nodecentral/Audi-Seat-Controller-Arduino-Project/README.md

# Audi Q8 Seat Control Reverse-Engineering Project

Repurposing an Audi `4N0959748D` switch assembly (Preh `13250-757/0200`) as a standalone control
interface for 12V seat motors in a different vehicle. This document tracks what's been measured
on the OEM hardware so far, the wiring scheme inferred from it, and what's still open before it
moves from the test bench into a vehicle.

> **Status:** the full chain — pushbutton → YYLOCK-2 power latch → buck converter → Nano → switch
> panel → Cytron → motor — is **confirmed working end-to-end on the bench** for two of the four
> axes (`fore_aft`, `recline`), including a dummy 12V motor. `front_tilt`/`rear_tilt` and the
> second Cytron board they need are **parked for now** (cost), not a technical blocker. Nothing has
> been installed in a vehicle yet — see
> [Vehicle integration checklist](#vehicle-integration-checklist) for what's still open before that.

## Voltage domains

This system has two electrically separate voltage domains that must never be tied together
directly:

| Domain | Voltage | Covers |
|---|---|---|
| **Motor power** | 12V (vehicle supply) | Cytron `B+`/`B-` terminals → seat motors only |
| **Logic** | 5V | Nano and its ADC reference |

The car is a 12V system, but the Nano and the switch panel's signal lines are **not** — the Nano's
ADC reads 0–1023 against a 5V reference. Feeding 12V into a Nano analog/digital pin or into the
switch panel's signal lines directly will exceed the pin's rating and damage it. The 5V rail is
**derived from the 12V supply through a buck converter** (module marked `C1205003` — see [Logic
supply](#vehicle-integration-checklist) below) — it isn't a separate source you wire in
independently. The switch panel's own pull-up doesn't come from this rail at all: the Nano reads
its analog pins with `INPUT_PULLUP` (its own internal pull-up resistor), confirmed working —
switch panel PIN 6 turned out not to be needed and isn't connected to anything.

## Hardware inventory

| Component | Part / model | Role |
|---|---|---|
| Seat switch panel | Audi `4N0959748D`, PCB marked Preh `13250-757/0200` / `NCE02` — also cross-referenced by resellers to Audi S3 (8Y) | OEM Audi switch cluster — passive input device, 12-position connector |
| Mating connector | TE Connectivity `1534096-1` / `1-1534096-1`, 12-cavity — [sourced from AliExpress](https://www.aliexpress.com/item/1005004665778565.html), pre-wired pigtail | Plugs into the switch panel; wires already terminated, ready to connect to the Nano — see caveat below |
| Motor driver | Cytron MDD10A | Dual-channel 10A H-bridge DC motor driver |
| Motor driver control cable | KF2510 2.54mm 5-pin pre-crimped cable, 20cm, 26AWG — sourced from eBay (listing: "KF2510 2.54mm Connectors & Wire Cable 2 3 4 5 6 Pin 20cm 26AWG UK SELLER", seller Electronic-Workshop) | Connectorised end mates with the MDD10A's `DIR1/PWM1/DIR2/PWM2/GND` header; the other end is bare flying leads that land on the Nano (via the HW-152 terminal adapter). Bought as a 2-pack, covering both this board and the second one still to be sourced |
| Microcontroller | Arduino Nano (ATmega328) | Reads switch panel, drives motor controller |
| Breakout | HW-152 "Nano Terminal Adapter V1.0" | Screw-terminal breakout for the Nano's header pins |
| Logic supply regulator | 12V→5V buck converter, module marked `C1205003`, 15W, 5V/3A max output | Steps the constant 12V feed down to 5V for the Nano and switch panel; see [Logic supply](#vehicle-integration-checklist) for the recommended wiring — bypass the pre-attached micro-USB cable |
| Power latch module | Garosa YYLOCK-2 self-locking delay-relay module, `SLA-12VDC-SL-C` relay, 30A/250VAC or 30A/30VDC at the module level, delay 0s–100min — sourced, bench-tested | Pushbutton-powered, self-latching wake/auto-off controller; its relay contacts also carry the actual switched load (Cytron `B+` + buck converter) — see [Power latch](#power-latch) |
| Power latch pushbutton | DMiotech 22mm momentary SPDT illuminated pushbutton (`C`/`NO`/`NC`), IP66 — sourced | User-facing wake trigger, dash or seat-mounted; only `C`+`NO` used, `NC` left disconnected; draws zero current when not pressed |

### Switch panel

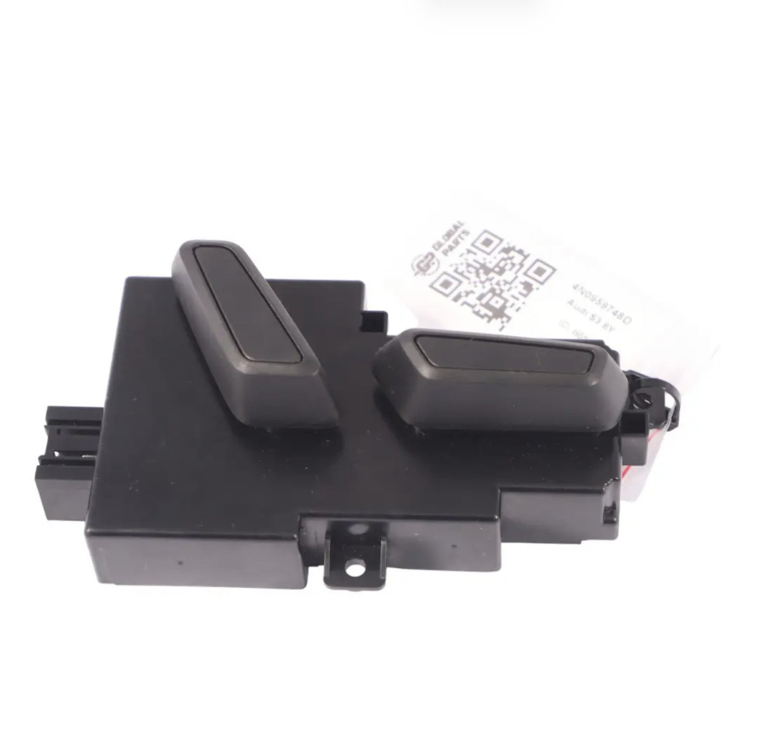
[picture p1: images/switch-unit-assembled.jpg]
Assembled switch unit with both rocker paddles


*Assembled unit as removed from the seat, part label `4N0959748D` / "Audi S3 8Y" visible. Two large
rocker paddles are what the user actually presses — not the eight individual tactile switches seen
on the bare PCB below. Each paddle rocks on 4 corners, each corner pressing a different underlying
switch: 2 paddles × 4 corners = the 8 switches already documented, and lines up exactly with 4
axes × 2 directions each. This is a standard mechanical pattern for this style of OEM seat switch.*

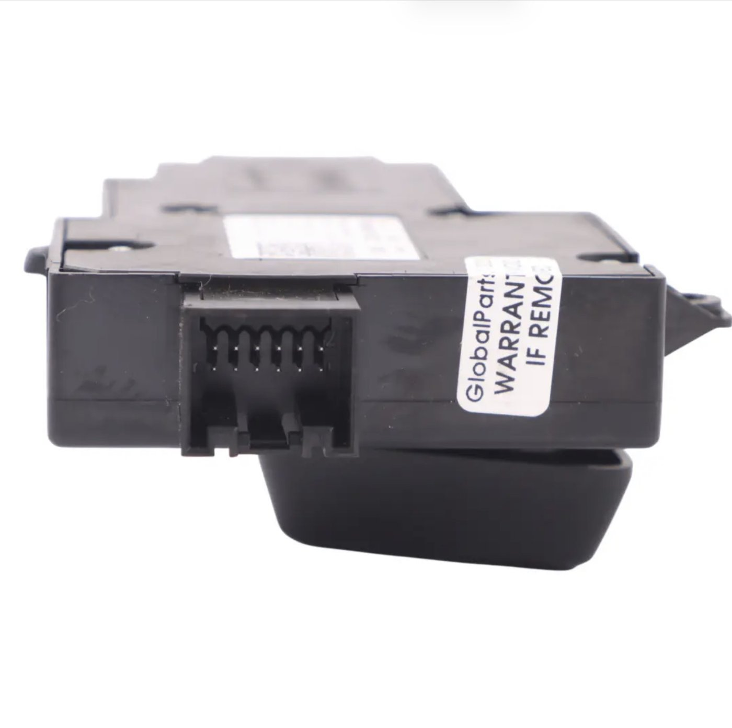
[picture p2: images/switch-unit-connector.jpg]
Male connector header molded into the switch housing


*The mating connector is molded directly into the housing — this is the physical point the TE
pigtail (below) plugs into.*

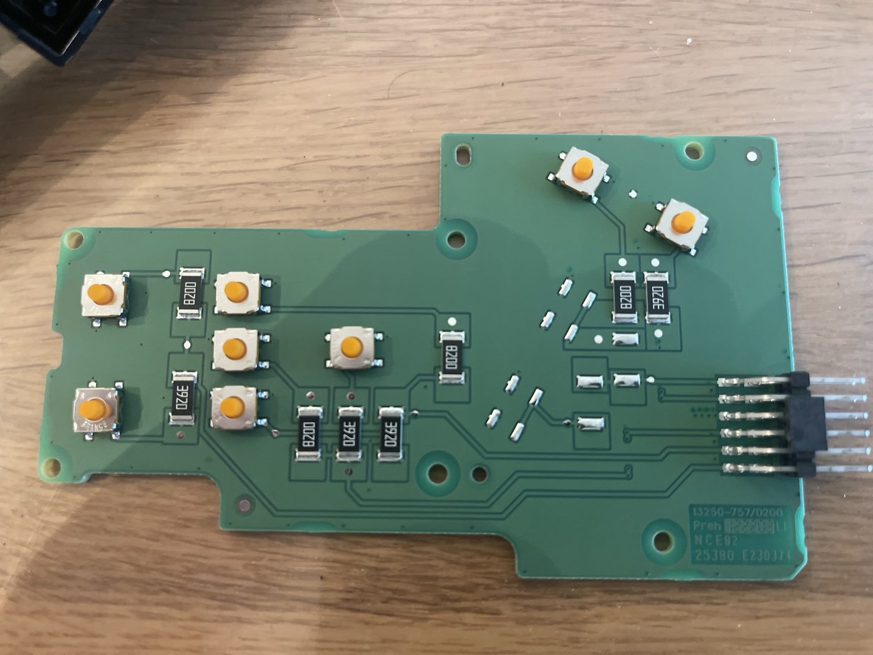
[picture p3: images/switch-panel-full.jpg]
Preh switch panel, full board


*Full switch panel (back side). Eight tactile switches are visible, wired through two repeated SMD
resistor values (silkscreened `8200` and `3920` — read as 820 Ω and 392 Ω using the standard
3-digit + multiplier code, unverified against a multimeter). Eight switches across four movement
axes lines up with two buttons (one per direction) per axis, each routed through a different
resistor — see [Inferred signal encoding](#inferred-signal-encoding) below.*

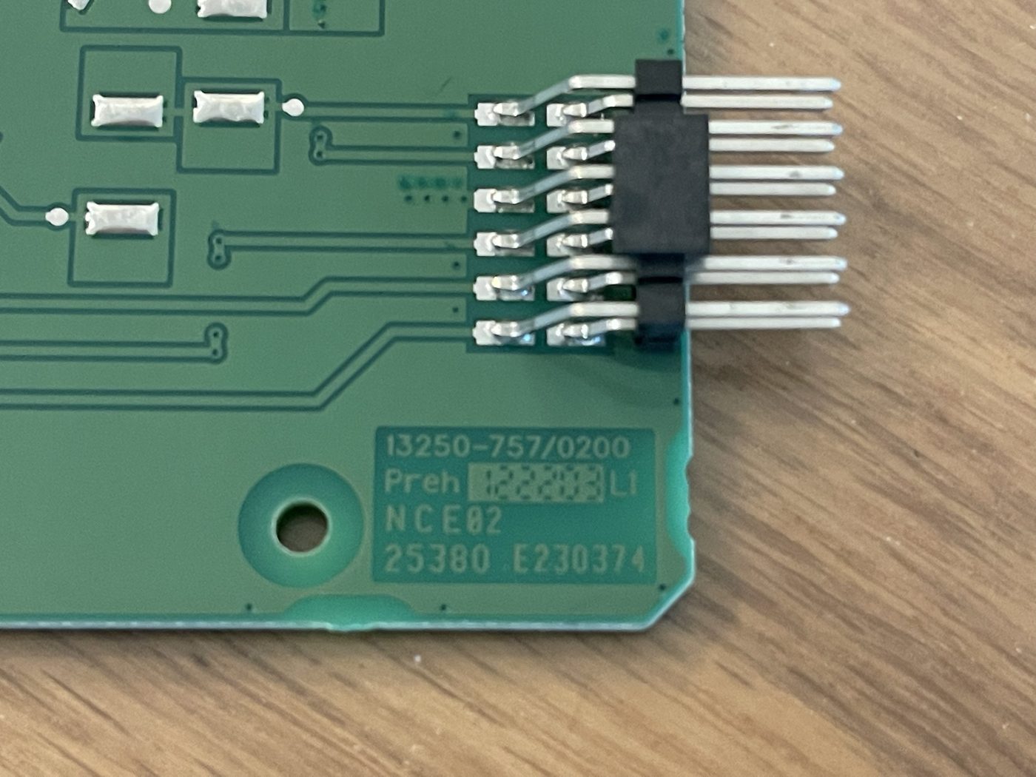
[picture p4: images/switch-connector-closeup.jpg]
Preh switch panel connector close-up


*Close-up of the panel's output connector, part marking `13250-757/0200 Preh NCE02 25380.E230374`.
The panel's case takes a 12-position mating connector (TE Connectivity `1534096-1` /
`1-1534096-1`) — only 6 of those 12 cavities have been identified as functional so far (see
[Confirmed control mapping](#confirmed-control-mapping)); the other 6 are unaccounted for, not
confirmed empty.*

> **Sourcing note:** that TE part number is what online listings sell as a match, cross-referenced
> against VW `8E0972112A` and described there as a "radar" harness connector — i.e. it's being sold
> as a generic shell reused across several VAG harnesses, not something listed specifically for this
> seat switch. A pre-wired pigtail version has been bought and physically mates with the panel,
> which confirms cavity count/pitch/keying are correct — what's still unconfirmed is which of the
> pigtail's 12 wires correspond to which of the panel's cavities (see below).

**Open item:** the pigtail presumably brings out all 12 wires, most likely colour-coded or otherwise
distinguishable per cavity — but that mapping (wire colour/position → cavity number → the PIN 1–6
functions already identified) hasn't been recorded here yet. Trace each wire from the connector back
to its cavity before wiring anything to the Nano, and don't rely on wire colour alone matching a
generic pinout found online, since this connector is sold as a shared shell across multiple VAG
applications.

### Motor driver

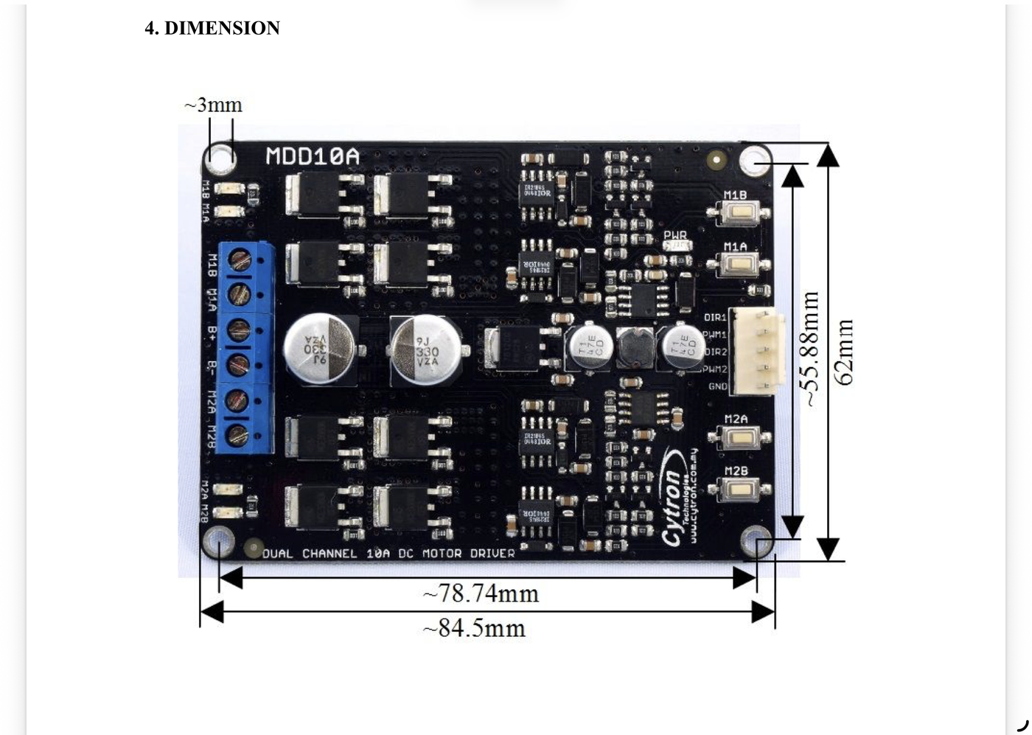
[picture p5: images/cytron-mdd10a-dimensions.png]
Cytron MDD10A dimensions and pinout


*Cytron MDD10A dual-channel 10A DC motor driver. Terminal block: `M1B / M1A / B+ / B- / M2A / M2B`.
Control header: `DIR1 / PWM1 / DIR2 / PWM2 / GND` — a standard 2.54mm 5-position connector, matched
by the KF2510 pigtail in the [hardware inventory](#hardware-inventory) above. This board only
drives two motors — see [Next Steps](#next-steps) for the implication on a 4-axis seat.*

**Resolved:** the KF2510 cable's 5 bare leads have been traced and landed on the Nano via the
HW-152 terminal adapter, matching the assignment in
[`seat_control_main.ino`](firmware/seat_control_main/seat_control_main.ino) — fore_aft: `D4`=DIR1
(black), `D5`=PWM1 (red); recline: `D7`=DIR2 (white), `D6`=PWM2 (yellow); GND=orange. Confirmed
from both ends, not assumed from a fixed wire-colour order — this specific cable turned out to be
plugged in reversed relative to the Cytron's own `DIR1/PWM1/DIR2/PWM2/GND` silkscreen order, which
is why cross-checking both ends mattered.

### Controller

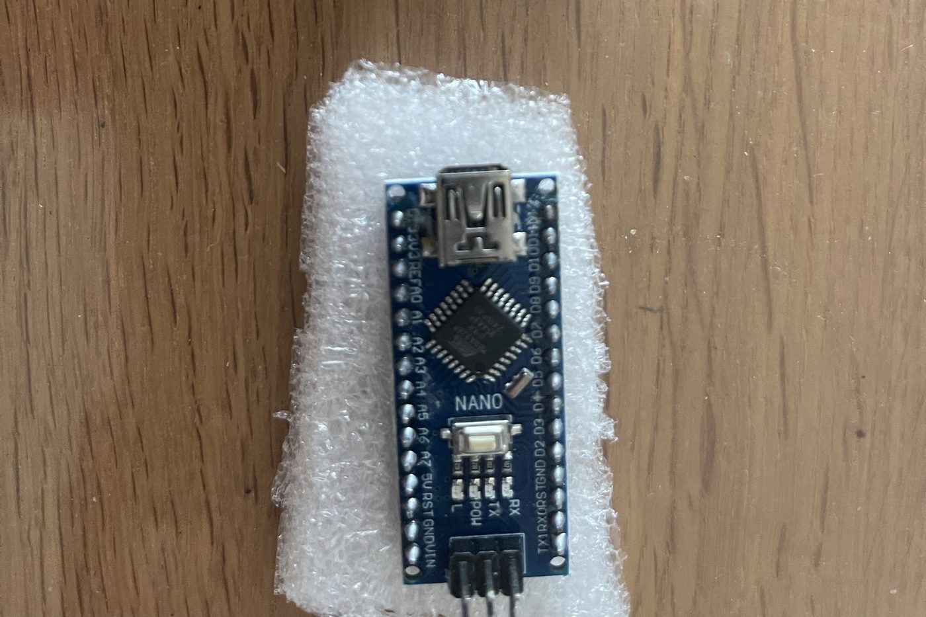
[picture p6: images/arduino-nano.jpg]
Arduino Nano

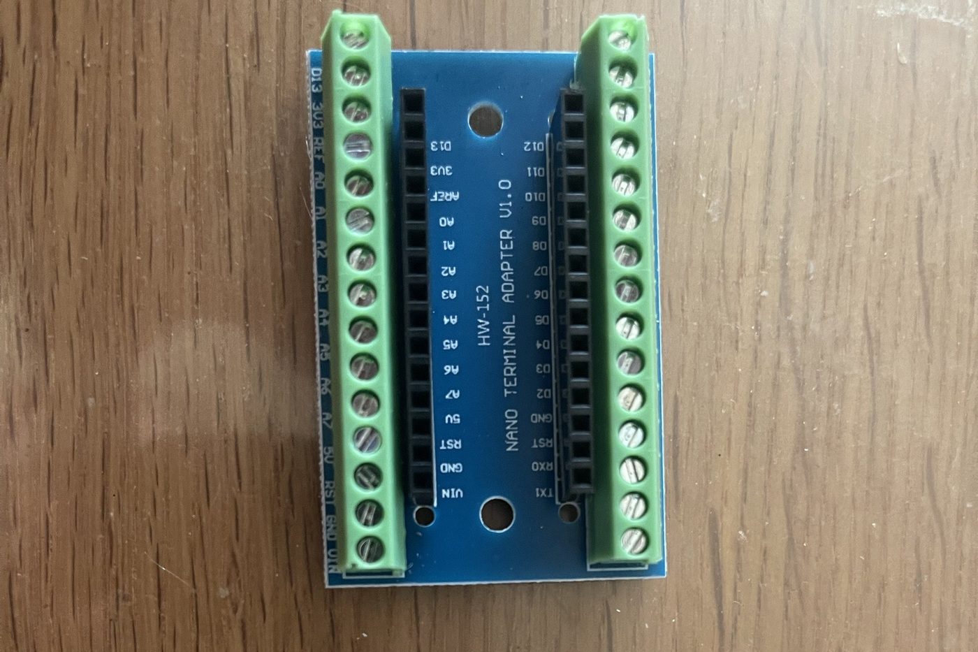
[picture p7: images/nano-terminal-adapter.jpg]
HW-152 Nano terminal adapter


*Arduino Nano and the HW-152 screw-terminal adapter used to break out its header pins for
solderless wiring to the switch panel and motor driver.*

## Key Findings

The switch PCB functions as a passive input device rather than a motor controller. Directional
information is encoded through resistance networks, not separate connector pins. The Arduino
successfully decoded PIN 1 signals (10-bit ADC, 0–1023):

| State | ADC reading |
|---|---|
| Neutral (no button pressed) | ~1023 |
| Downward adjustment | ~27–28 |
| Upward adjustment | ~40–41 |

The large gap between neutral (~1023, i.e. pulled high) and either pressed state (~27–41, pulled
sharply low) indicates a pull-up on the line with a low-value resistor switched in to ground on
each button press — different resistors per direction, which is exactly the two repeated SMD
values (820 Ω / 392 Ω) visible on the panel. That pull-up is the Nano's own internal one
(`INPUT_PULLUP`), confirmed working — not an external 5V feed (see [Voltage
domains](#voltage-domains)).

PIN 3 (fore_aft) and PIN 5 (recline) have since been independently confirmed on real hardware,
with very similar but not identical values — backward ~25–30, forward ~38–43. The small difference
from PIN 1's numbers above is expected: different axes' resistors and the switch to
`INPUT_PULLUP` both shift the exact thresholds slightly, which is exactly why each axis needs
measuring rather than assumed identical.

## Confirmed control mapping

| Pin | Function | Status |
|---|---|---|
| PIN 1 | Front seat-base tilt | Identified (ADC values above); axis not yet wired to a driver |
| PIN 2 | Rear seat-base tilt | Identified, ADC values not yet measured; axis not yet wired to a driver |
| PIN 3 | Entire seat forward/backward movement (`fore_aft`) | **Confirmed working** — Nano `A3` |
| PIN 4 | Common reference (ground) | Confirmed |
| PIN 5 | Backrest recline adjustment (`recline`) | **Confirmed working** — Nano `A5` |
| PIN 6 | Unused | **Confirmed not connected to anything** — not needed; the Nano's internal pull-up (`INPUT_PULLUP`) does this job instead |

The panel's mating connector has 12 cavities (see [hardware inventory](#hardware-inventory)); PINs
1–6 above are the ones identified so far. The remaining 6 cavities haven't been probed — they may
be unused on this panel variant, reserved for other functions (e.g. lumbar, memory buttons) present
on related Preh panels but not populated here, or something else entirely. Don't assume they're
empty until checked.

## Inferred signal encoding

Working theory for how each axis line behaves, based on the eight switches and two resistor values
on the panel plus the PIN 1 readings above. This is inferred from photos, not confirmed by
continuity testing — verify with a multimeter before relying on it:

```
         Nano internal pull-up (INPUT_PULLUP)
                         |
Nano ADC pin  <----------+----------  e.g. PIN 3 (fore_aft)
                         |
              +----------+----------+
              |                     |
         [~820R]                [~392R]
        "down" resistor       "up" resistor
              |                     |
          SW down                SW up
              |                     |
              +----------+----------+
                         |
                 PIN 4 (GND, common return)
```

Confirmed: the pull-up is internal to the Nano, not an external 5V feed — PIN 6 isn't connected to
anything (see [Confirmed control mapping](#confirmed-control-mapping)).

Each of the four movement pins (1, 2, 3, 5) is expected to follow this same pattern: idle high
(~1023), pulled to a low-but-distinct ADC value depending on which of the two direction buttons for
that axis is pressed. That matches the panel having 8 switches for 4 axes (2 directions each), and
the two SMD resistor values repeating across the board — and now that the assembled unit's been
seen (see [Switch panel](#switch-panel)), it also matches the physical layout exactly: 2 external
rocker paddles, each a 4-corner rocker, giving 2 × 4 = 8 underlying switches.

## Proposed system wiring

End-to-end wiring from battery to motors, based on the parts in the [hardware
inventory](#hardware-inventory). Only PIN 1's behavior is empirically confirmed; the rest of this
is a proposed build, not a verified one.

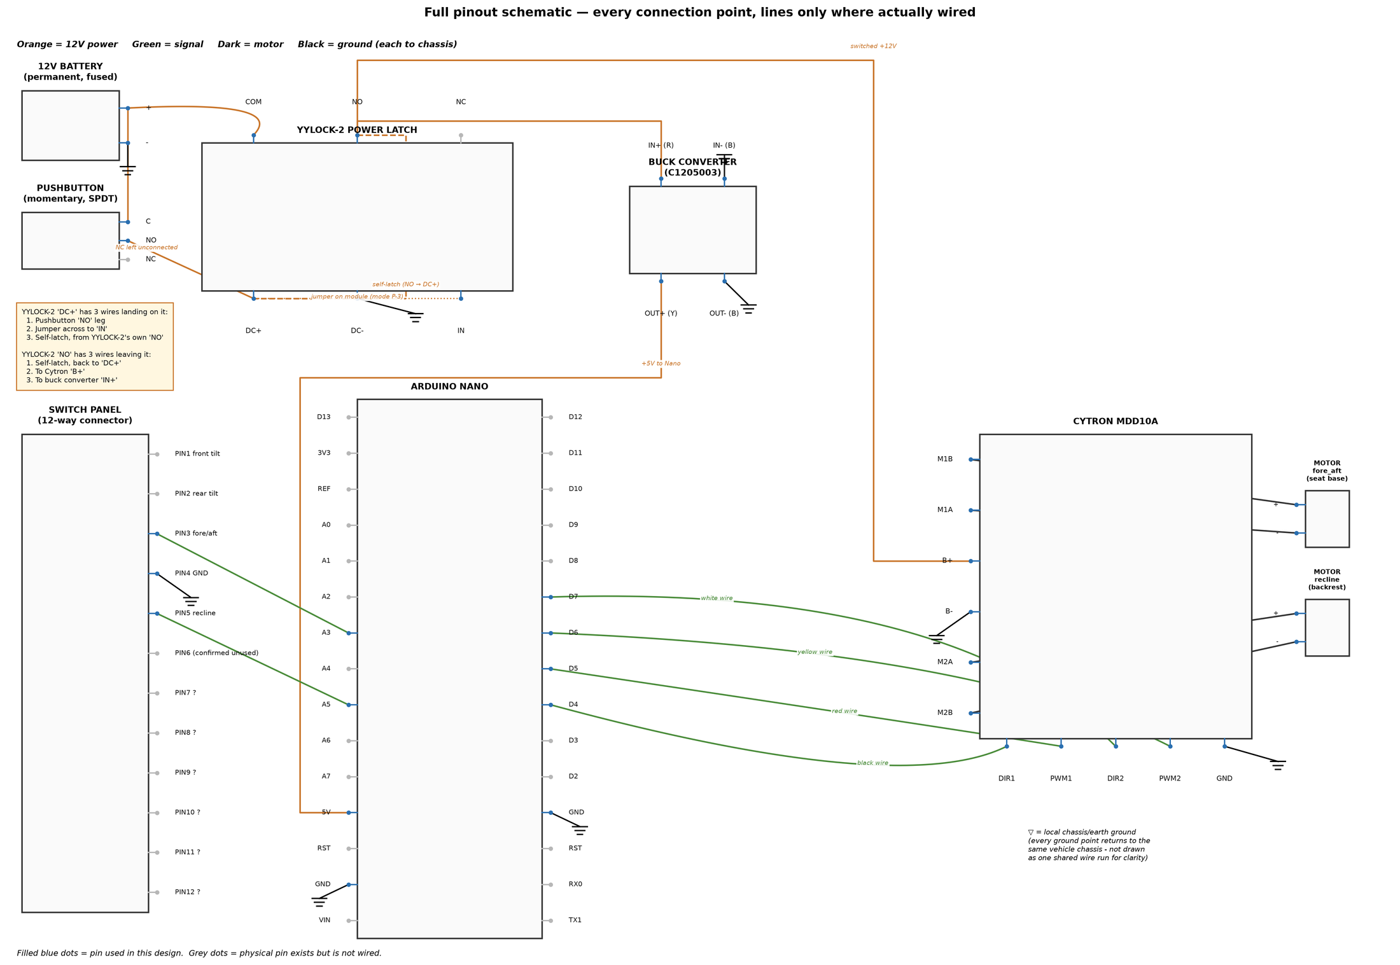
[picture p8: images/full-pinout-schematic.png]
Full pinout schematic showing every physical connection point on every component, with only the wired ones connected


*Every connection point on every component, drawn like a circuit board view — filled blue dots are
pins actually wired in this design; grey dots are real pins on the part that are simply unused
(e.g. the switch panel's 6 unidentified cavities, the pushbutton's and YYLOCK-2's `NC` contacts,
most of the Nano's pins). Orange = 12V power, green = signal, dark = motor output. Each `▽` is a
local chassis/earth ground symbol — every ground point (battery, YYLOCK-2, buck converter, Nano
×2, Cytron ×2, switch panel PIN 4) returns to the same vehicle chassis; they're drawn as separate
local symbols rather than one wire run joining them all, since in the car they don't share a
physical wire back to a single point anyway. The pushbutton is drawn as the real SPDT part (`C`/
`NO`/`NC`) — only `C` and `NO` are used, `NC` stays disconnected. The Nano↔Cytron control cable's
real wire colours are labelled on those four signal lines (black→`DIR1`, red→`PWM1`, yellow→
`PWM2`, white→`DIR2`) — confirmed on both ends: traced from the Nano side, then cross-checked
against the Cytron-side pin order you read directly off the cable (which turned out to be plugged
in reversed relative to the Cytron's own `DIR1/PWM1/DIR2/PWM2/GND` silkscreen order — both
readings agree, so this mapping is solid.*

For a lower-detail overview, the same system split into just power and signal flow:

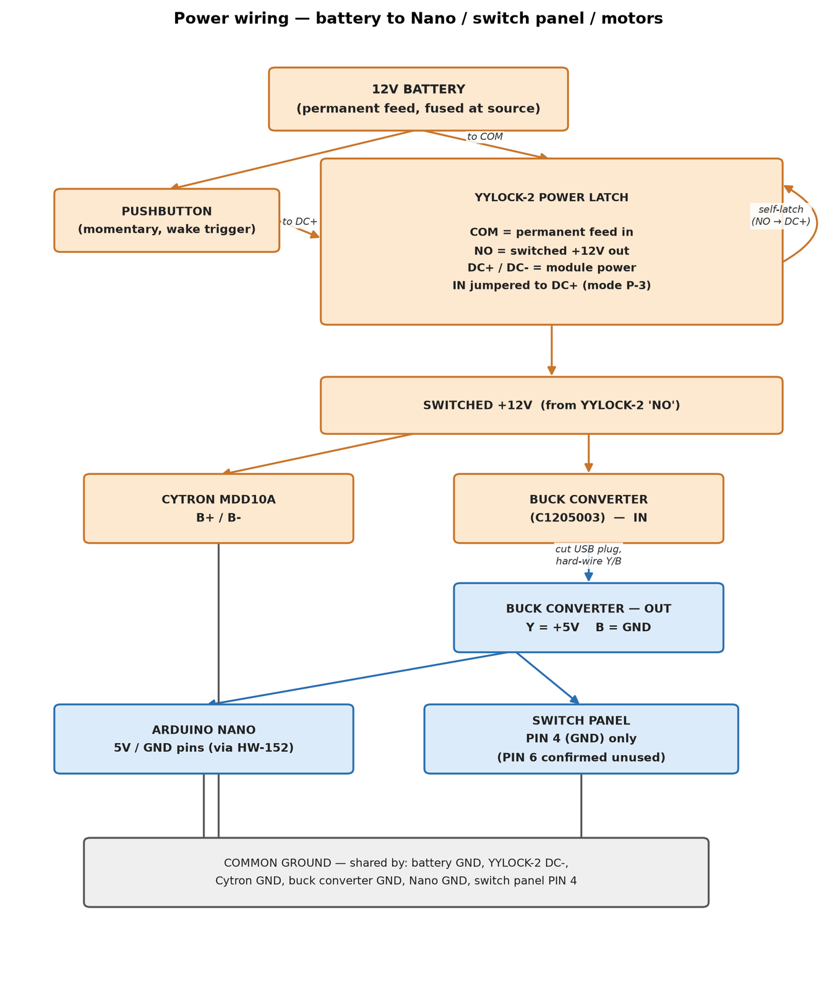
[picture p9: images/power-wiring.png]
Power wiring diagram: battery through the power latch to Nano, switch panel, and Cytron


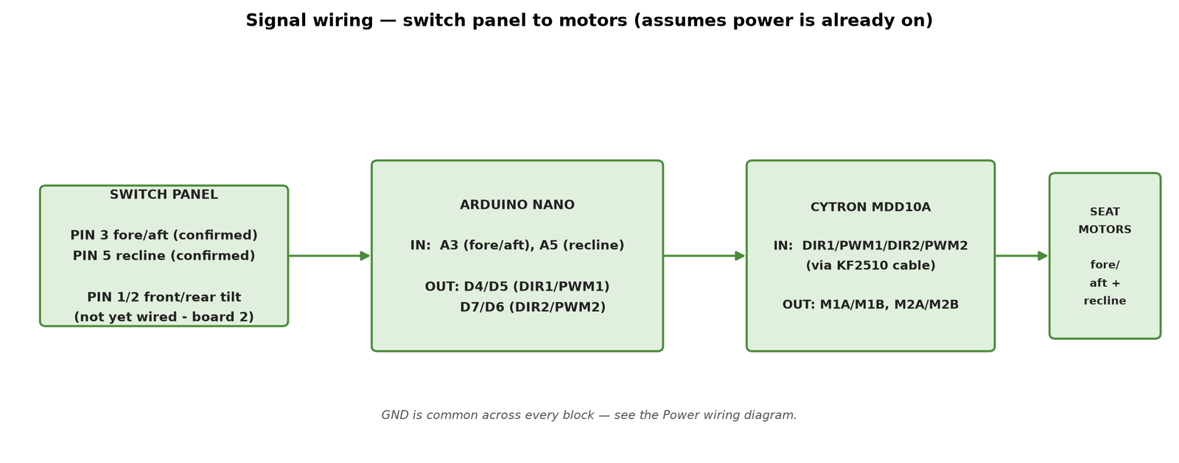
[picture p10: images/signal-wiring.png]
Signal wiring diagram: switch panel through Nano and Cytron to the motors


A pin-level Mermaid version of the same system, for reference:

```mermaid
flowchart LR
    subgraph SWITCH["Preh switch panel (13250-757/0200)"]
        P1["PIN 1 — front tilt<br/>(not yet wired to a driver)"]
        P2["PIN 2 — rear tilt<br/>(not yet wired to a driver)"]
        P3["PIN 3 — fore/aft"]
        P5["PIN 5 — recline"]
        P4["PIN 4 — GND"]
        P6["PIN 6 — confirmed unused"]
    end

    subgraph NANO["Arduino Nano (via HW-152 terminal adapter)"]
        A3n["A3"]
        A5n["A5"]
        GND1["GND"]
        FIVEV["5V"]
        CTRL1["D4/D5 — DIR1/PWM1 (fore_aft)"]
        CTRL2["D7/D6 — DIR2/PWM2 (recline)"]
    end

    subgraph DRV1["Cytron MDD10A #1 (drives 2 of 4 axes)"]
        M1["M1A/M1B"]
        M2["M2A/M2B"]
        BSUP["B+ / B-"]
    end

    P3 --> A3n
    P5 --> A5n
    P4 --> GND1
    REG -. proposed .-> FIVEV

    CTRL1 --> M1
    CTRL2 --> M2

    MOT1["Seat motor — fore_aft (seat base)"]
    MOT2["Seat motor — recline (backrest)"]
    M1 --> MOT1
    M2 --> MOT2

    BATT["12V vehicle supply, permanent, fused"] --> PBTN["Pushbutton<br/>(not yet sourced)"]
    BATT --> LATCH["YYLOCK-2 'COM'"]
    PBTN --> DCPLUS["YYLOCK-2 'DC+'<br/>(IN jumpered to DC+, mode P-3)"]
    LATCH -- closes onto NO when triggered --> NOOUT["YYLOCK-2 'NO'<br/>(switched +12V out)"]
    NOOUT -- self-latch --> DCPLUS
    NOOUT --> BSUP
    NOOUT --> REG["12V→5V buck converter<br/>(C1205003, hardwired — no USB cable)"]
    BSUP --> M1
    BSUP --> M2

    DRV2["Cytron MDD10A #2 (needed for remaining 2 axes:<br/>front tilt and rear tilt on D2/D3 and D8/D9,<br/>exact pairing TBD)<br/>— not yet built"]
    CTRL1 -.-> DRV2
```

Note only two of the four confirmed movement axes can be driven per MDD10A board — a second driver
board is needed to cover all four (see Next Steps). The 12V supply only ever reaches the `B+`/`B-`
motor terminals; everything else (switch panel, Nano, ADC lines) runs on the 5V rail produced by
the regulator, per [Voltage domains](#voltage-domains).

## Power latch

The controller needs to work with the ignition off (so seat position can be adjusted before
getting in), but the whole point is that it must **not** sit drawing current 24/7 off the permanent
12V feed — that's how you come back to a dead battery. Solution: a single self-locking delay-relay
module (Garosa YYLOCK-2 or equivalent: `SLA-12VDC-SL-C` relay, 30A/250VAC or 30A/30VDC rated at the
module level — not just the bare relay chip, terminals sized to match) whose own power input, not
just a signal pin, is gated by a pushbutton. At rest, nothing downstream has any power at all.

```
+12V permanent (fused) ----+------------------------------------+
                            |                                    |
                      [pushbutton]                          YYLOCK "COM"
                      (momentary)                        (permanent feed in)
                            |                                    |
                            +--------------+          closes onto "NO" when
                                           |            the relay is energized
                                     YYLOCK "DC+" <----------- YYLOCK "NO"
                                           |               (switched +12V out)
                                     YYLOCK "IN" (jumpered to DC+
                                     on the module itself — mode P-3)
                                           |
                                     YYLOCK "DC-" ---> common GND

switched +12V (from "NO") ---> Cytron B+ and buck converter IN (both fed from here)
```

- **Wake:** pressing the pushbutton applies 12V to the module's `DC+`/`DC-`. Because `IN` is
  permanently jumpered to `DC+`, the module sees itself as already triggered the instant it powers
  up — no separate trigger wiring needed.
- **Mode P-3** ("Timed Output Mode"), per the module's manual: *"if the input is continuously
  shorted, the relay activates for the set delay period and then deactivates until power is
  removed."* That's the whole behavior in one sentence — relay closes immediately, stays closed for
  a delay set via the `SET` button (aim for 10–15 minutes), then opens and stays open until power
  is fully cycled again.
- **Self-latch and load, same contact:** the relay's `NO`/`COM` pair is wired back to `DC+` in
  parallel with the pushbutton (so releasing the button changes nothing — the module now holds its
  own power on) **and** feeds the buck converter + Cytron `B+` downstream. One 30A-rated contact
  pair does both jobs — no separate main relay needed, unlike the two-stage design this replaces.
  Concretely, that means `DC+` has **3 wires** landing on it (pushbutton `NO`, the `IN` jumper,
  and this self-latch wire), and `NO` has **3 wires** leaving it (self-latch back to `DC+`, to
  Cytron `B+`, to the buck converter's `IN+`) — easy to undercount at a glance in the diagram, so
  spelled out here and called out directly on the schematic itself.
- **Auto-off:** when the set delay elapses, the relay opens, cutting its own power and the
  downstream load together — including the Nano. At rest, the pushbutton is open and the module has
  no power on it: draw is genuinely zero.
- **No firmware role:** `seat_control_main.ino` has no power-management code — the module handles
  wake and timeout entirely on its own hardware.

Other modes exist (`P-1` self-locking/toggle, `P-2` power-off delay, `P-4` delayed-on) but none fit
this use case — see the module's manual for the full function list if reconsidering.

**Bench-tested and confirmed** (module + pushbutton + multimeter, nothing else attached):
- Mode `P-3` with `IN` shorted to `DC+` behaves exactly as documented: relay clicks on immediately,
  stays on for the set delay, then clicks off on its own. Retriggering `IN` while already active
  does **not** extend the delay — matches the manual's "subsequent input signals during the delay
  period are ignored," and is what this design wants (fixed, generous duration, no need to keep it
  retriggered). One practical consequence: if a seat-adjustment session ever runs longer than the
  set duration, the system will power off mid-session and need the wake button pressed again.
- The module retains its configured mode and delay across a full power cycle, as advertised — this
  mattered more here than usual, since the module's own power is cut every time it sleeps by
  design.
- Timing dial: turning it **clockwise decreases** the delay, anti-clockwise increases it (per the
  board's own label). The mode switch also controls whether the dial's range is seconds or
  minutes — worth double-checking that switch position, since it's easy to read a "few seconds"
  result as broken when it's actually just set to minutes (or vice versa).

**Still open:**
- Confirm real-world current handling under a load similar to actual motor stall current before
  trusting the 30A rating for good — the module-level rating is more credible than a bare relay
  chip's printed number, but hasn't been independently verified here.

## Firmware

| Sketch | Purpose |
|---|---|
| [`firmware/diagnostic_read_switch_panel`](firmware/diagnostic_read_switch_panel/diagnostic_read_switch_panel.ino) | Prints raw ADC values for `fore_aft`/`recline` (confirmed working) plus the two unconfirmed `front_tilt`/`rear_tilt` pins (`A1`, `A2`) over serial. Use it once the second Cytron board exists to find out which of `A1`/`A2` is which axis. |
| [`firmware/seat_control_main`](firmware/seat_control_main/seat_control_main.ino) | Control loop: reads all four axes, drives the Cytron board(s), and stops a motor if it's held on past an 8-second safety cutoff. Has no role in power management — the [power latch](#power-latch) handles wake/auto-off entirely in hardware. `fore_aft`/`recline` thresholds are confirmed working; `front_tilt`/`rear_tilt` copy the same placeholder values until that board exists and gets measured. |

`fore_aft` and `recline` are confirmed running on real hardware, using the Nano's internal
`INPUT_PULLUP` rather than an external 5V feed. `front_tilt`/`rear_tilt` are still inert pending
the second Cytron board.

## Vehicle integration checklist

Not started. Before any of this touches a vehicle:

- **Wire gauge** — two sizes, not one: **16 AWG (~1.5mm²)** for anything on the direct
  battery-to-motor current path (power in → YYLOCK-2 `COM`, `NO` → Cytron `B+`, `B-` → ground, and
  the 4 motor output wires) — sourced from existing stock, confirmed stranded (not solid core) and
  genuinely full-gauge copper before use, given it's carrying the only real current in this build.
  **22 AWG (~0.33mm², Fermerry silicone/tinned-copper hookup wire, 6 colours)** for everything
  else — switch panel signals, Nano↔Cytron control signals, the buck converter's input and output,
  and the YYLOCK-2/pushbutton/LED wiring. Simple rule: thick wire only between the battery and a
  motor terminal, thin wire for everything else.
- **Power source** — decided: a permanent 12V feed, already fused from the car's main board into a
  fuse box. Add a dedicated small inline fuse there for this circuit specifically, sized to what it
  actually draws — the existing upstream fuse protects the main distribution wiring, not this
  circuit's own branch wire (see [Next Steps](#next-steps)). Seat adjustment needs to work with the
  ignition off, which rules out simply gating this off an ignition-switched circuit — instead the
  feed goes through the [power latch](#power-latch) relay, so the controller draws no standby
  current between uses despite being fed from a permanent source.
- **Logic supply** — sourced: a 12V→5V buck converter (module marked `C1205003`, 15W, rated 5V/3A
  output — comfortably more than the Nano will ever draw; the switch panel doesn't need any of this
  rail, since it's read via the Nano's own internal pull-up, not an external 5V feed). It
  comes with a pre-attached micro-USB cable meant for powering the Nano through its USB port — for
  a permanent vehicle install, **don't use that USB connection**. A USB plug isn't rated for
  continuous vibration and is one more failure point with no benefit here. Instead: cut off (or
  ignore) the micro-USB plug, and wire the module's `Y` (yellow, +5V out) and `B` (black, GND out)
  leads directly into the Nano's `5V` and `GND` pins via the HW-152 terminal adapter you already
  have. Fuse the module's `R` (red, 12V in) lead separately from the motor supply fuse — 1A is
  ample headroom for what this rail actually powers. **Never connect 12V straight to the Nano's
  `5V` pin** — only the module's regulated 5V *output* goes there; the module's 12V *input* side is
  a completely separate pair of wires. Confirm from the MDD10A datasheet whether it already has an
  onboard 5V logic output before assuming you need this converter for anything beyond the Nano.
- **Common ground** — switch panel PIN 4, Nano GND, both Cytron boards' GND, and the 12V supply
  return all need to share one reference; a floating or high-resistance ground will show up as
  garbage ADC readings on the switch panel lines before it shows up anywhere else.
- **Target motor ratings** — get the stall current and connector type for the seat motors in the
  destination vehicle. The MDD10A is rated 10A/channel continuous; confirm the motors' stall
  current stays under that with margin, and size wiring/fuses to the stall figure, not the running
  figure.
- ~~**Connector matching**~~ — done: pre-wired pigtail (TE `1534096-1` / `1-1534096-1`) bought and
  confirmed to mate with the panel. Still open: trace and record which of its 12 wires land on
  which cavity, per the note under [Switch panel](#switch-panel).
- **Enclosure** — sourced: **Hammond `1599HBK`**, IP54 black ABS, 220×110×44mm external. Houses
  all four boards (YYLOCK-2, buck converter, Nano, Cytron). Connectors sourced to match: two
  9-pin 5.08mm pluggable panel-mount terminal blocks (one for the pushbutton, one for the switch
  panel — both grouped on the seat-facing side, since both route there), a 4-pin for the motor
  outputs, a 2-pin for power in — 3 physical connection points total, panel-mount/pluggable so the
  box can be unplugged from the harness rather than desoldered.

  **Depth is the thing to verify before final mounting, not footprint.** 44mm external is roughly
  36–38mm clear internal once you allow for the walls and a mounting plate. The YYLOCK-2's relay is
  the tallest single component in this build (a 30A-rated relay body is commonly 20–25mm on its
  own) — stacked with the PCB and any standoff clearance, that's plausibly pushing 28–32mm. It
  likely fits, but closely enough that it's worth measuring the actual relay height and the box's
  real internal clearance before drilling or gluing anything down. A physical dry-fit settles this
  faster than any diagram can.

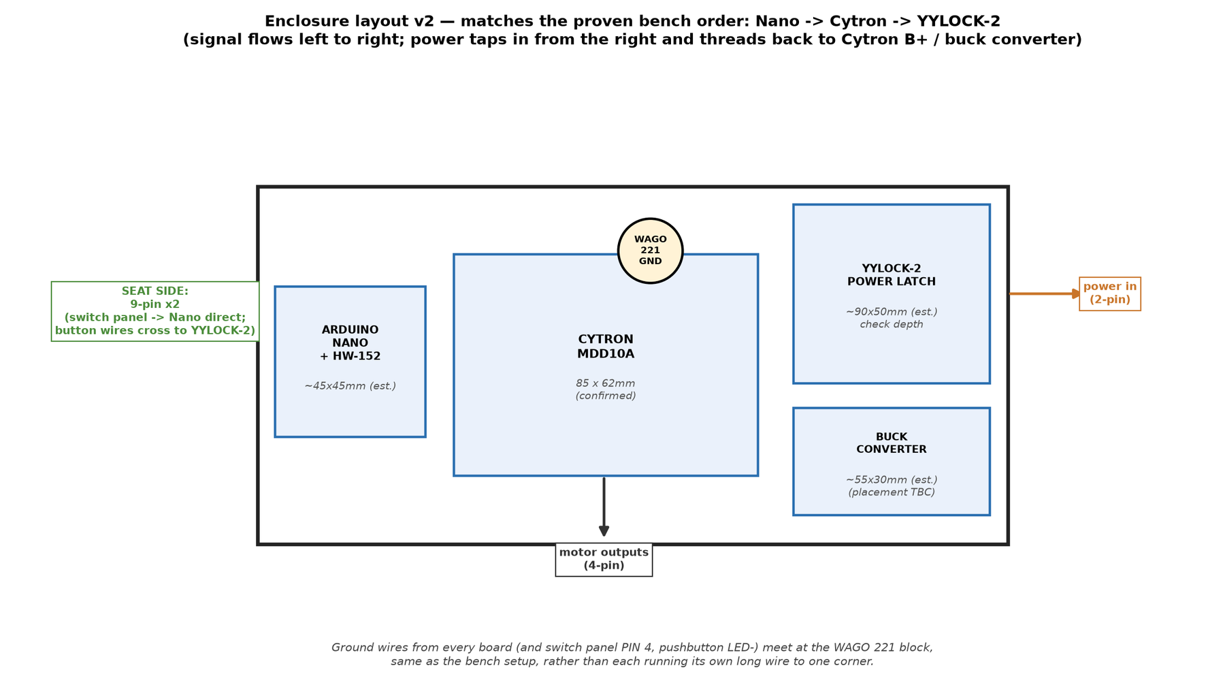
[picture p11: images/enclosure-layout.png]
Enclosure layout for the Hammond 1599HBK: top-down view showing Nano, Cytron, YYLOCK-2, buck converter, and WAGO ground block placement, matching the proven bench order
  

  *Layout follows the order already proven working on the bench: **Nano → Cytron → YYLOCK-2**,
  left to right. Signal flows one direction — switch panel into the Nano (left), Nano's control
  lines into the Cytron (middle), Cytron's outputs to the motors (bottom) — while power taps in
  from the right (near the YYLOCK-2) and threads back to Cytron `B+` and the buck converter. A WAGO
  `221` lever connector serves as the common ground junction, same as on the bench, rather than
  each board running its own long wire to one corner. Buck converter is grouped with the YYLOCK-2
  since that's where it takes its input from — flag if it should sit elsewhere. About a third of
  the footprint is spare, so this is one workable arrangement, not the only one.*

## Next Steps

**Parked for now:** `front_tilt`/`rear_tilt` and the second Cytron MDD10A board they need are
deliberately deferred — cost-driven decision, not a technical blocker. The items below (measuring
PINs 1/2, finding which of `A1`/`A2` is which axis, sourcing the second board, updating their
placeholder thresholds) all wait on that decision being revisited.

- Measure the YYLOCK-2 relay's actual height and the Hammond `1599HBK`'s real internal clearance
  before final mounting — see [Enclosure](#vehicle-integration-checklist), depth is tight.
- Confirm the two SMD resistor values (silkscreened `8200` / `3920`) by direct measurement rather
  than reading the printed code from photos.
- Probe the 6 unaccounted-for cavities on the 12-position connector — confirm whether they're
  genuinely unused or carry signals not yet identified.
- The pigtail wires actually needed (PINs 3, 4, 5) are landed and confirmed working end-to-end on
  the bench. The other 9 cavities' wires still aren't traced/recorded — not blocking, since nothing
  currently needs them, but worth doing before assuming the rest of the pigtail is understood.
- ~~Wire the buck converter's `Y`/`B` output leads directly to the Nano's `5V`/`GND` pins~~ — done,
  confirmed working on the bench (no micro-USB cable used).
- ~~Source and bench-test the power latch module~~ — done, see [Power latch](#power-latch):
  P-3 behavior and settings-retention across a power cycle both confirmed on real hardware.
- **Fine-tune later, once it's installed and has run reliably for a while:** an optional small
  electrolytic capacitor (100–470µF) across the YYLOCK-2's `DC+`/`DC-`, to make the power-on more
  tolerant of a soft/incomplete pushbutton press — smooths a brief or bouncy contact into a more
  sustained power pulse. Not needed now; the button just needs a firm, deliberate press, which is a
  reasonable property for a wake button anyway. Revisit only if it proves annoying in practice.
- **Roadmap, not release 1:** drop the buck converter and power the Nano directly from `VIN`
  instead (7–12V straight from the switched rail, using the Nano's own onboard regulator) — viable
  now that PIN 6 is confirmed unused, since the buck converter's only remaining job is powering the
  Nano itself, whose draw is small enough that the regulator's efficiency loss is negligible. Would
  take this from a 4-board build down to 3. Release 1 keeps the buck converter as-is — it's already
  wired, tested, and working, and it gives a bit of extra regulation headroom as a safeguard over
  relying on the Nano's own onboard regulator. Worth exploring properly on the second build (a
  second instance of this whole project is planned) rather than reworking the proven one.
- Decide on and mount the pushbutton location (dashboard vs. seat).
- Vehicle power source: a fused 12V feed already exists from the main board into a fuse box.
  **Add a dedicated small inline fuse there for this circuit specifically** — the upstream fuse
  protects the main distribution wiring, not this circuit's own (thinner) branch wire, so it needs
  its own fuse sized to what this circuit actually draws. Pick the rating once real-world stall
  current is measured (see [Power latch](#power-latch) — still open).
- Work through the rest of the [vehicle integration checklist](#vehicle-integration-checklist) —
  chassis grounding, connector matching, enclosure — before connecting any seat motor in the car.
  Do not wire B+/B- to the vehicle 12V supply until that's done.
