nodecentral/Audi-Seat-Controller-Arduino-Project/(commit log)

2026-09-13 Document reverse-engineering process for Audi seat control
    Added detailed notes on reverse-engineering the Audi Q8 seat control switch, including objectives, findings, pin mapping, and proposed Arduino architecture.
2026-09-13 Restructure README with photos and inferred wiring diagram
    Adds hardware photos (switch panel, Cytron MDD10A driver, Arduino Nano
    + terminal adapter), a PIN 6 hypothesis based on the resistor-ladder
    pattern visible on the switch board, and a proposed end-to-end wiring
    diagram from switch panel through to the motor driver.
2026-09-13 Add draft firmware and vehicle integration checklist
    Diagnostic sketch reads all four switch-panel axes for the still-missing
    PIN 2/3/5 calibration data. Main control sketch drafts the Nano-to-Cytron
    control loop with a safety cutoff, using placeholder thresholds copied
    from the confirmed PIN 1 measurement. README gains a Firmware section and
    a vehicle integration checklist covering power, grounding, motor ratings,
    connectors, and enclosure — none of which has been designed yet.
    [diagnostic_read_switch_panel.ino, seat_control_main.ino]
2026-09-13 Clarify 12V vs 5V voltage domains throughout README
    Adds an explicit Voltage domains section explaining why the switch
    panel/Nano logic runs on 5V (forced by the Nano's ADC reference) while
    only the motors run on the vehicle's 12V, and that 5V must be derived
    from 12V via a regulator rather than treated as a separate source.
    Updates the wiring diagram to show that derivation, and corrects the
    Nano VIN vs 5V pin guidance in the integration checklist (VIN accepts
    12V through the onboard regulator; the 5V pin does not and would be
    destroyed by 12V).
2026-09-13 Document 12-position mating connector, correct 6-pin assumption
    Switch panel's case takes a 12-cavity connector (TE 1534096-1 /
    1-1534096-1, sold cross-referenced to VW 8E0972112A), not the 6-pin
    connector previously assumed from the PCB header photo alone. The 6
    signal pins already mapped account for only half the cavities — the
    rest are flagged as unaccounted for rather than assumed empty. Adds a
    sourcing caveat since the part cross-reference comes from a generic
    listing, not a confirmed fitment match.
2026-09-13 Record that the mating connector has been sourced and confirmed to fit
    Pre-wired pigtail (TE 1534096-1 / 1-1534096-1) bought from AliExpress
    and confirmed to physically mate with the switch panel, which resolves
    the cavity count/pitch/keying uncertainty flagged earlier. What's still
    open is tracing which of the pigtail's 12 wires land on which cavity
    before connecting anything to the Nano.
2026-09-13 Document KF2510 control cable for the Cytron MDD10A
    Records the KF2510 2.54mm 5-pin pre-crimped cable sourced from eBay to
    mate with the MDD10A's DIR1/PWM1/DIR2/PWM2/GND header. Bought as a
    2-pack, which conveniently covers the second driver board still on the
    Next Steps list. Flags that wire-to-position tracing is still needed
    before connecting it to the Nano, same caveat as the switch panel
    pigtail.
2026-09-13 Clarify KF2510 cable is connector-to-flying-leads, not connector-to-connector
    The MDD10A-side end is a proper KF2510 housing; the Nano-side end is
    bare wire, landing on the Nano via the HW-152 terminal adapter. Ties
    the remaining wiring task directly to the pin assignment already in
    seat_control_main.ino rather than leaving it abstract.
2026-09-13 Document 12V-to-5V buck converter, recommend bypassing its USB cable
    Sourced C1205003 15W buck converter steps the constant 12V feed down
    to 5V for the Nano and switch panel. Recommends wiring its Y/B output
    leads directly to the Nano's 5V/GND pins via the HW-152 adapter instead
    of routing through the pre-attached micro-USB cable, which isn't
    suited to a permanent, vibration-exposed install. Also records the
    power source as a confirmed constant (non-switched) 12V feed and flags
    the resulting standby-current tradeoff.
2026-09-13 Add power latch design to solve standby battery drain
    Adds a relay-based power latch: a momentary pushbutton and a Nano GPIO
    (POWER_HOLD_PIN, D12) both gate a relay on the permanent 12V feed. The
    button wakes the system; the Nano immediately takes over holding the
    relay closed; after 5 minutes of switch-panel inactivity it releases
    the latch, dropping the whole controller (including itself) to zero
    standby draw. This replaces the earlier ignition-switched fallback,
    since the seat needs to be adjustable with the ignition off.
    Implements the latch/timeout logic in seat_control_main.ino, adds a
    Power latch section with a circuit diagram to the README, updates the
    system wiring diagram to show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
    [seat_control_main.ino]
2026-09-13 Switch power latch design to a sourced trigger-delay relay module
    Replaces the discrete relay+transistor+Nano-hold-forever design with
    an off-the-shelf SRD-12VDC-SL-C based "trigger delay turn off" module
    (sourced, comes with a matching momentary pushbutton). The module's own
    hardware timer does the final power cutoff, not the Nano holding a pin
    indefinitely — a hung/crashed Nano can now only fail to extend the
    delay, not keep the system powered forever, which is a meaningfully
    safer failure mode on a permanent 12V feed.
    seat_control_main.ino now pulses POWER_KEEPALIVE_PIN (D12) every ~2s
    while there's switch-panel activity, mimicking a fresh button press to
    retrigger the module, instead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
    [seat_control_main.ino]
2026-09-13 Add assembled switch unit photos, correct part number, explain paddle mechanism
    Part number corrected to 4N0959748D (was missing a digit) per the
    visible part label, cross-referenced by resellers to Audi S3 (8Y).
    Photos of the assembled housing show the panel is operated via two
    large rocker paddles, not eight individual buttons directly — each
    paddle rocks on 4 corners, each corner pressing one of the 8 tactile
    switches already documented on the bare PCB. This explains the switch
    count/layout mechanically and lines up with the existing 4-axes x
    2-directions resistor-ladder theory, rather than leaving them as two
    separate, unconnected observations.
2026-09-14 Correct power latch design: pilot module + separate main relay
    The delay-relay modules considered so far (including the previously
    documented SRD-12VDC-SL-C board) have relays rated ~5-10A, well under
    the ~10A+ stall current a single Cytron channel can draw - neither was
    ever suitable for switching motor power directly, which the previous
    write-up didn't flag. Corrected design: the pushbutton now powers the
    new LCD-programmable delay module directly (not just a trigger pin),
    its relay self-latches its own power and pilots a separate, properly
    rated (~30A class) main relay whose contacts carry the actual load.
    This also lets the module handle wake/auto-off entirely in hardware,
    via a duratio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
    [seat_control_main.ino]
2026-09-15 Simplify power latch to a single self-locking relay module
    Replaces the two-stage pilot-module-plus-main-relay design with one
    YYLOCK-2-style module (SLA-12VDC-SL-C relay, 30A rated at the module
    level, not just the bare relay chip). Its NO/COM contacts both
    self-latch the module's own power on and carry the actual switched
    load to the buck converter and Cytron B+, since 30A gives real margin
    over Cytron's 10A/channel stall current - no separate main relay
    needed.
    Mode P-3 with IN permanently jumpered to DC+ gives the required
    behavior directly, confirmed from the module's own manual: relay
    closes on power-up, holds for a set delay, then opens and stays open
    until power is fully cycled - ex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
2026-09-17 Add rendered power/signal wiring diagrams as the primary reference
    The previous combined ASCII diagram packed power and signal paths
    into one dense drawing that was hard to follow. Replaces it with two
    separate rendered images - power (battery through the latch to Nano/
    switch panel/Cytron) and signal (switch panel through Nano and Cytron
    to the motors) - each simple enough to read at a glance. The existing
    pin-level Mermaid diagram stays as a secondary, more detailed
    reference underneath.
2026-09-17 Add full pinout schematic as the primary wiring reference
    Shows every physical connection point on every component (Nano's full
    30-pin layout, the switch panel's all 12 cavities, YYLOCK-2's 6
    terminals, Cytron's 11) with only the actually-wired pins connected -
    unused pins stay visible as grey dots rather than being omitted, so
    it's clear what's spare vs. what's committed (e.g. the switch panel's
    6 unidentified cavities, the YYLOCK-2's NC contact). The earlier
    simpler power/signal block diagrams stay as a lower-detail overview
    underneath.
2026-09-19 Fix schematic routing and add proper chassis-ground wiring
    Reroutes the two worst wire crossings (YYLOCK NO to Cytron B+, and
    buck converter output to Nano/switch panel) via clear channels around
    the boxes instead of diagonals cutting through them. Replaces the
    dashed grey ground bus with solid black ground wiring terminating at
    an explicit chassis/earth ground symbol, matching how ground actually
    works in a vehicle - one common chassis reference, not a wire run back
    to the battery for every component.
2026-09-19 Use local ground symbols instead of a shared bus, add confirmed cable colors
    Replaces the shared ground rail/trunk with a small chassis-ground
    symbol at each individual ground point - simpler to read and more
    honest about there being no single physical wire joining them all in
    the car (they share a chassis, not a wire run).
    Also labels the Nano-Cytron control cable's four signal wires with
    their confirmed real-world colors (black/red/yellow/white), read from
    the physical KF2510 cable's Nano-side landing. Flags in Next Steps and
    the diagram caption that the Cytron-side end of that cable still needs
    independent confirmation before fully trusting the mapping.
2026-09-19 Show pushbutton's real SPDT terminals, confirm KF2510 cable mapping both ends
    Pushbutton now drawn as the actual DMiotech part (C/NO/NC) instead of
    a generic 2-terminal placeholder, matching how every other component
    in the schematic shows its real terminals with unused ones greyed out.
    The Nano-Cytron control cable's wire-to-function mapping is now
    confirmed from both ends (previously only traced from the Nano side):
    black=DIR1, red=PWM1, yellow=PWM2, white=DIR2, orange=GND. The cable
    turned out to be plugged in reversed relative to the Cytron's own
    silkscreen order, which is why the two independent readings needed
    cross-checking against each other rather than just trusting one.
    Updates h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
2026-09-19 Correct front_tilt/rear_tilt pin assignment to match physical wiring
    Physical confirmation from the KF2510 cable: front_tilt's DIR1/PWM1
    land on D4/D5, not the D2/D3 firmware previously assumed. Since D4/D5
    were already reserved for rear_tilt (the second, not-yet-built Cytron
    board), swaps the two axes' pin assignments instead of just relabeling
    - front_tilt now uses D4/D5 (matching physical reality), rear_tilt
    moves to the now-free D2/D3. Same four pins in total use, just
    correctly assigned to what's actually wired today.
    Updates seat_control_main.ino, the full pinout schematic (D2/D3 now
    shown unused/grey, D4/D5 used/blue, with the signal curves re-fanned
    to avoid crossing now that all fo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
    [seat_control_main.ino]
2026-09-19 Correct axis names/pins and resolve the PIN 6 mystery from real hardware
    Confirmed from the user's actual working code and wiring:
    - fore_aft ("seat base") is on Nano A3, not A2 as previously guessed
    - recline ("backrest") is on Nano A5, not A3 as previously guessed
    - PIN 6 is confirmed NOT connected to anything - the long-standing
    "+5V pull-up supply" hypothesis was wrong. The Nano reads the switch
    panel using its own internal INPUT_PULLUP instead.
    - Switch panel PIN 4 = GND, PIN 5 = recline -> Nano A5, both confirmed
    directly, matching what was already documented/just corrected.
    front_tilt and rear_tilt remain unbuilt (second Cytron board), still
    sharing A1/A2 with the specific pair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
    [diagnostic_read_switch_panel.ino, seat_control_main.ino]
2026-09-19 Record power latch bench-test results: P-3 and memory retention confirmed
    Real hardware testing confirms: mode P-3 behaves exactly as documented
    (non-retriggerable one-shot - a plus for this design, not a limitation,
    since it means fixed duration with zero Nano involvement), and the
    module retains its mode/delay setting across a full power cycle as
    advertised. Also records the timing dial's direction (clockwise =
    less time) and flags the seconds/minutes switch as an easy thing to
    misread when troubleshooting.
    Closes out the corresponding Next Steps item and marks the module as
    sourced in the hardware inventory. Only remaining open item on this
    part: real-world current verification under act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
2026-09-19 Make the YYLOCK-2 DC+/NO 3-wire junctions explicit on the diagram
    Converging lines alone didn't make it obvious that both DC+ and NO
    each carry three separate wires - easy to undercount by eye. Adds a
    callout box directly on the schematic spelling out both junctions
    explicitly, and the same detail in the Power latch section prose.
2026-09-19 Record full end-to-end bench success for fore_aft/recline
    The complete chain - pushbutton, YYLOCK-2 power latch, buck converter,
    Nano, switch panel, Cytron, and a dummy 12V motor - is now confirmed
    working together on the bench, not just as isolated subsystems. Updates
    the status header and closes out the Next Steps items this resolves
    (buck converter wiring, core pigtail wiring). Remaining open items are
    now clearly about the second Cytron board and moving from bench to an
    actual vehicle installation, not bench validation.
2026-09-19 Park front_tilt/rear_tilt, note capacitor as future fine-tuning, confirm fusing plan
    front_tilt/rear_tilt and the second Cytron board are explicitly parked
    - a cost decision, not a technical blocker - reworded status header
    and Next Steps to reflect that rather than listing them as active
    pending work.
    Records the pushbutton's soft-press capacitor idea as an optional
    future fine-tune once the system's had real-world runtime, not an
    immediate task.
    Records the actual vehicle power source: a fused 12V feed from the
    car's main board into a fuse box, with a dedicated small inline fuse
    to be added there for this circuit specifically, sized once real-world
    stall current is measured. Explains why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
2026-09-19 Add proposed enclosure layout for all four boards
    Top-down layout diagram sized to real board dimensions (YYLOCK-2
    ~90x50mm, buck converter ~55x30mm, Nano+HW-152 ~50x65mm, Cytron
    ~85x62mm) within a ~220x160mm internal enclosure area. Power flows
    left-to-right from the 12V entry through YYLOCK-2 to the buck
    converter/Cytron; signal flows top-to-right from the switch panel
    through the Nano to the Cytron and out to the motors. Leaves open
    space for a terminal strip landing the external wire bundles (12V/GND,
    5-wire seat controller with 2 spares reserved for the parked second
    board, 4-wire pushbutton/LED, 4-wire motor outputs) before
    distribution to the boards.
    Updates the Enclosure checklist i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
2026-09-21 Update enclosure plan to match actual sourced box and connectors
    Records the real purchase: Hammond 1599HBK (220x110x44mm external,
    IP54), plus two 9-pin panel-mount connectors (pushbutton + switch
    panel, grouped on the seat-facing side), a 4-pin for motor outputs,
    and a 2-pin for power - 3 connection points total, matching what was
    actually sourced rather than the earlier generic 4-edge sketch.
    Regenerates the layout diagram for this box's real (smaller) internal
    footprint. Flags the real risk clearly: box depth (44mm external, ~36-
    38mm internal estimated) is tight against the YYLOCK-2 relay's height,
    unlike the footprint which fits with room to spare. Adds a Next Steps
    item to physically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
2026-09-21 Rework enclosure layout to match the proven bench order
    Previous layout grouped boards by rough size rather than following any
    particular logic. Rebuilds it around the order already tested and
    working on the bench: Nano -> Cytron -> YYLOCK-2 left to right, so
    signal flows one direction (switch panel -> Nano -> Cytron -> motors)
    while power taps in from the opposite side and threads back to Cytron
    B+ and the buck converter. Adds the WAGO 221 lever connector as an
    explicit component - the actual common ground junction used on the
    bench - rather than leaving grounding as an abstract "meets at a
    symbol" concept in this diagram. Buck converter placement (grouped
    with YYLOCK-2) is flagged as an as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
2026-09-21 Add buck-converter-to-VIN simplification as a roadmap item, not release 1
    Now that PIN 6 is confirmed unused, the buck converter's only
    remaining job is powering the Nano itself - light enough load that
    feeding VIN directly from the switched rail would work fine, dropping
    this from a 4-board build to 3. Release 1 keeps the buck converter as
    proven/tested/working, with the regulation headroom as a safeguard;
    this gets explored properly on the second build rather than reworking
    a working reference system.
2026-09-26 Document wire gauge decision: 16 AWG power, 22 AWG signal
    Two sizes only, split by whether a wire ever carries motor current.
    16 AWG (existing stock, to be verified stranded and full-gauge before
    use) for the battery-to-motor path; 22 AWG (Fermerry silicone/tinned-
    copper hookup wire) for everything else - switch panel, Nano/Cytron
    control signals, buck converter, YYLOCK-2/pushbutton/LED wiring.
2026-10-24 Add enclosure wiring diagram, wiring list and pre-power-up tests
    - images/enclosure-wiring.png/.svg: build diagram for the Hammond 1599HBK
    in the bench order (Nano + buck, Cytron, WAGO, YYLOCK-2), with every
    terminal in its real position: YYLOCK relay COM/NO/NC and DC block
    DC+/DC-/IN from the maker's labelled photo, Cytron header read off the
    board. Includes a numbered wiring list, safety notes, wires per
    terminal and a pre-power-up checklist.
    - WIRING.md: the same wiring as text, how the latch works, and tests
    T1-T4 (stall current / F1, relay under load, latch and timeout,
    pushbutton pinout).
    - tools/enclosure_wiring_diagram.py: generator for the diagram.
    - README: relay fitt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
